shyrzaza/MicroMouseArbeit/readme.txt

How to use

Install 

Python 3.5
PyQT
PyQTGraph
PySerial

Send via UART

POS:XXXX:VEL:XXXX:SEN:XXXX:CON:XXXX 
(length of numbers is not important)
(look at uart.h sendDiagnostics() method
