shyrzaza/MicroMouseArbeit/PartList Mouse 2020.xlsx

 | Order number | Link | Price | Pack Size | Total | check
 | RS-Num |  | per part, without taxes
Motor: | - |  |  |  | 2
LEDs:
Throughhole | 862-2790 | https://de.rs-online.com/web/p/led/8622790/ | 0.069 | 100 | 2 | 2
 | 708-2787 | https://de.rs-online.com/web/p/led/7082787/ | 0.28 | 25 | 3 | 3
Capacitors:
100 nF | 264-4416 | https://de.rs-online.com/web/p/keramik-vielschichtkondensatoren/2644416/ | 0.162 | 25 | 8 | 8
330 nF | 698-3421 | https://de.rs-online.com/web/p/keramik-vielschichtkondensatoren/6983421/ | 0.334 | 25 | 1 | 1
470nF | 698-3437 | https://de.rs-online.com/web/p/keramik-vielschichtkondensatoren/6983437/ | 0.184 | 10 | 1 | 1
15 pF | 264-4242 | https://de.rs-online.com/web/p/keramik-vielschichtkondensatoren/2644242/ | 0.014 | 25 | 2 | 2
4,7 μF | 648-0581 | https://de.rs-online.com/web/p/tantal-elektrolytkondensator/6480581/ | 0.27 | 10 | 1 | 1
33 uF Tantalum | 135-5417 | https://de.rs-online.com/web/p/tantal-elektrolytkondensator/1355417 | 1.1 | 5 | 1 | 1
Resistors:
47 kΩ | 223-0641 | https://de.rs-online.com/web/p/smd-widerstande/2230641/ | 0.03 | 50 | 2 | 2
62 Ω | 828-0869 | https://de.rs-online.com/web/p/smd-widerstande/8280869/ | 0.112 | 45 | 2 | 2
680 Ω | 679-1614 | https://de.rs-online.com/web/p/smd-widerstande/6791614/ | 0.004 | 50 | 3 | 3
4.7 KΩ | 223-0528 | https://de.rs-online.com/web/p/smd-widerstande/2230528/ | 0.028 | 50 | 2 | 2 | transistor
Diodes:
 | 708-2197 | https://de.rs-online.com/web/p/gleichrichterdioden-und-schottky-dioden/7082197/ | 0.259 | 25 | 9 | 9
Pin Headers:
2x5 Straight Male | 745-7059 | https://de.rs-online.com/web/p/leiterplatten-header/7457059/ | 0.323 | 10 | 1
2x3 Straight Male | 745-7046 | https://de.rs-online.com/web/p/leiterplatten-header/7457046/ | 0.226 | 10 | 2
1x6 Straight Female | 674-1546 | https://de.rs-online.com/web/p/leiterplatten-buchsen/6741546/ | 1.61 | 5 | 1
DIL Socket | 674-2432 | https://de.rs-online.com/web/p/dil-sockel/6742432/ | 0.206 | 10 | 1
Transistors:
 | 509-273 | https://de.rs-online.com/web/p/mosfet/0509273/?searchHistory=%7B%22enabled%22%3Atrue%7D | 0.254 | 20 | 2 | 2
Voltage regulators:
5V | 536-1546 | https://de.rs-online.com/web/p/ldo-spannungsregler/5361546/?searchHistory=%7B%22enabled%22%3Atrue%7D | 1.47 | 1 | 1 | 1
3.3V LD falsch? | 197-7281 | https://de.rs-online.com/web/p/ldo-spannungsregler/1977281/ | 1.38 | 5 | 1 | 1
Other:
H-Bridge | 714-0613 | https://de.rs-online.com/web/p/motor-treiber-ics/7140613/ | 3.3 | 1 | 1 | 1
Sensor | 146-0786 | https://de.rs-online.com/web/p/reflexions-lichtschranke/1460786/ | 7.16 | 1 | 3 | 3
Button | 135-9548 | https://de.rs-online.com/web/p/tastschalter/1359548/ | 0.169 | 20 | 2 | 2
Oscillator 16MHz |  |  |  |  | 1 | 1
BT-Serial-Modul |  |  |  |  | 1 | 1
Microcontroller | 823-3425 | https://de.rs-online.com/web/p/digitale-signalprozessoren/8233425/ | 5.95 | 1 | 1 | 1
Battery Connector |  |  |  |  | 1 | 1
