shyrzaza/MicroMouseArbeit/3DDruck/SensorMountSides.stl

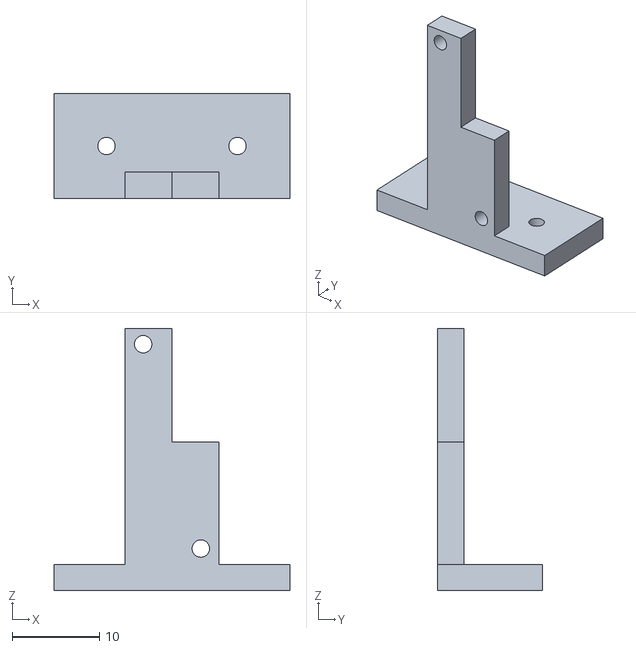
[picture p1: CAD file, 2020-09-17]
3DDruck/SensorMountSides.stl
27.0 x 12.0 x 30.0
