shyrzaza/MicroMouseArbeit/3DDruck/motormount.stl

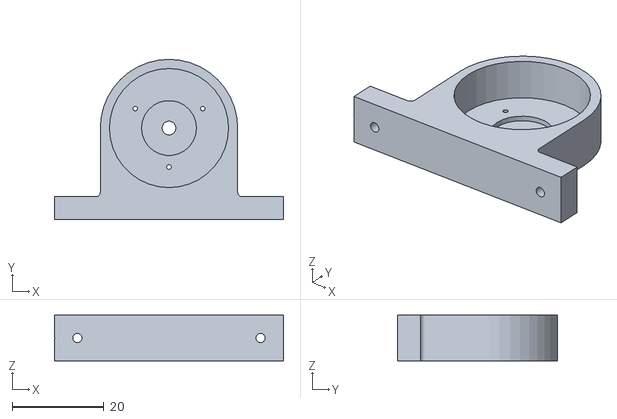
[picture p2: CAD file, 2020-09-17]
3DDruck/motormount.stl
50.0 x 35.0 x 10.0
