shyrzaza/MicroMouseArbeit/(list of files, cad)

Other CAD files:
3DDruck/SensorMountFront.stl
