shyrzaza/MicroMouseArbeit/Python/Debug.txt

POS:1:VEL:10:SENSOR:20:CON:5
POS:2:VEL:10:SENSOR:20:CON:5
POS:3:VEL:10:SENSOR:20:CON:5
POS:4:VEL:10:SENSOR:20:CON:5
POS:5:VEL:10:SENSOR:20:CON:5
POS:6:VEL:10:SENSOR:20:CON:5
POS:7:VEL:10:SENSOR:20:CON:5
POS:8:VEL:10:SENSOR:20:CON:5
POS:9:VEL:10:SENSOR:20:CON:5
POS:10:VEL:20:SENSOR:20:CON:5
POS:11:VEL:20:SENSOR:20:CON:5
POS:12:VEL:20:SENSOR:20:CON:5
POS:13:VEL:20:SENSOR:20:CON:5
POS:14:VEL:20:SENSOR:20:CON:5
POS:15:VEL:20:SENSOR:20:CON:5
POS:16:VEL:20:SENSOR:20:CON:5
POS:17:VEL:20:SENSOR:20:CON:5
POS:18:VEL:20:SENSOR:20:CON:5
POS:19:VEL:20:SENSOR:20:CON:5
POS:20:VEL:20:SENSOR:20:CON:5
POS:21:VEL:20:SENSOR:20:CON:5
POS:22:VEL:10:SENSOR:20:CON:5
POS:23:VEL:10:SENSOR:20:CON:5
POS:24:VEL:10:SENSOR:20:CON:5
POS:25:VEL:10:SENSOR:20:CON:5
POS:26:VEL:10:SENSOR:20:CON:5
POS:27:VEL:30:SENSOR:20:CON:5
POS:28:VEL:30:SENSOR:20:CON:5
POS:29:VEL:30:SENSOR:20:CON:5
POS:31:VEL:30:SENSOR:20:CON:5
POS:32:VEL:30:SENSOR:20:CON:5
POS:33:VEL:30:SENSOR:20:CON:5
POS:34:VEL:30:SENSOR:20:CON:5
POS:35:VEL:30:SENSOR:20:CON:5
POS:36:VEL:30:SENSOR:20:CON:5
POS:37:VEL:30:SENSOR:20:CON:5
POS:38:VEL:30:SENSOR:20:CON:5
POS:39:VEL:30:SENSOR:20:CON:5
POS:41:VEL:30:SENSOR:20:CON:5
POS:42:VEL:30:SENSOR:20:CON:5
POS:43:VEL:30:SENSOR:20:CON:5
POS:44:VEL:30:SENSOR:20:CON:5
POS:45:VEL:10:SENSOR:20:CON:5
POS:46:VEL:10:SENSOR:20:CON:5
POS:47:VEL:10:SENSOR:20:CON:5
POS:48:VEL:10:SENSOR:20:CON:5
POS:49:VEL:10:SENSOR:20:CON:5
POS:51:VEL:10:SENSOR:20:CON:5
POS:52:VEL:10:SENSOR:20:CON:5
POS:53:VEL:10:SENSOR:20:CON:5
POS:54:VEL:10:SENSOR:20:CON:5
POS:55:VEL:10:SENSOR:20:CON:5
POS:56:VEL:10:SENSOR:20:CON:5
POS:57:VEL:10:SENSOR:20:CON:5
POS:58:VEL:10:SENSOR:20:CON:5
POS:59:VEL:10:SENSOR:20:CON:5
POS:61:VEL:10:SENSOR:20:CON:5
POS:62:VEL:10:SENSOR:20:CON:5
POS:63:VEL:10:SENSOR:20:CON:5
POS:64:VEL:10:SENSOR:20:CON:5
POS:65:VEL:10:SENSOR:20:CON:5
POS:66:VEL:10:SENSOR:20:CON:5
POS:67:VEL:10:SENSOR:20:CON:5
POS:68:VEL:10:SENSOR:20:CON:5
POS:69:VEL:10:SENSOR:20:CON:5
POS:71:VEL:10:SENSOR:20:CON:5
POS:72:VEL:10:SENSOR:20:CON:5
POS:73:VEL:10:SENSOR:20:CON:5
POS:74:VEL:10:SENSOR:20:CON:5
POS:75:VEL:10:SENSOR:20:CON:5
POS:76:VEL:10:SENSOR:20:CON:5
POS:77:VEL:10:SENSOR:20:CON:5
POS:78:VEL:10:SENSOR:20:CON:5
POS:79:VEL:10:SENSOR:20:CON:5
POS:81:VEL:10:SENSOR:20:CON:5
POS:82:VEL:10:SENSOR:20:CON:5
POS:83:VEL:10:SENSOR:20:CON:5
POS:84:VEL:10:SENSOR:20:CON:5
POS:85:VEL:10:SENSOR:20:CON:5
POS:86:VEL:10:SENSOR:20:CON:5
POS:87:VEL:10:SENSOR:20:CON:5
POS:88:VEL:10:SENSOR:20:CON:5
POS:89:VEL:10:SENSOR:20:CON:5
POS:91:VEL:10:SENSOR:20:CON:5
POS:92:VEL:10:SENSOR:20:CON:5
POS:93:VEL:10:SENSOR:20:CON:5
POS:94:VEL:10:SENSOR:20:CON:5
POS:95:VEL:10:SENSOR:20:CON:5
POS:96:VEL:10:SENSOR:20:CON:5
POS:97:VEL:10:SENSOR:20:CON:5
POS:98:VEL:10:SENSOR:20:CON:5
POS:99:VEL:10:SENSOR:20:CON:5
