shyrzaza/MicroMouseArbeit/source eagle/projects/micromouse/micromouse.brd

## EAGLE design source eagle/projects/micromouse/micromouse.brd (2020-11-19)

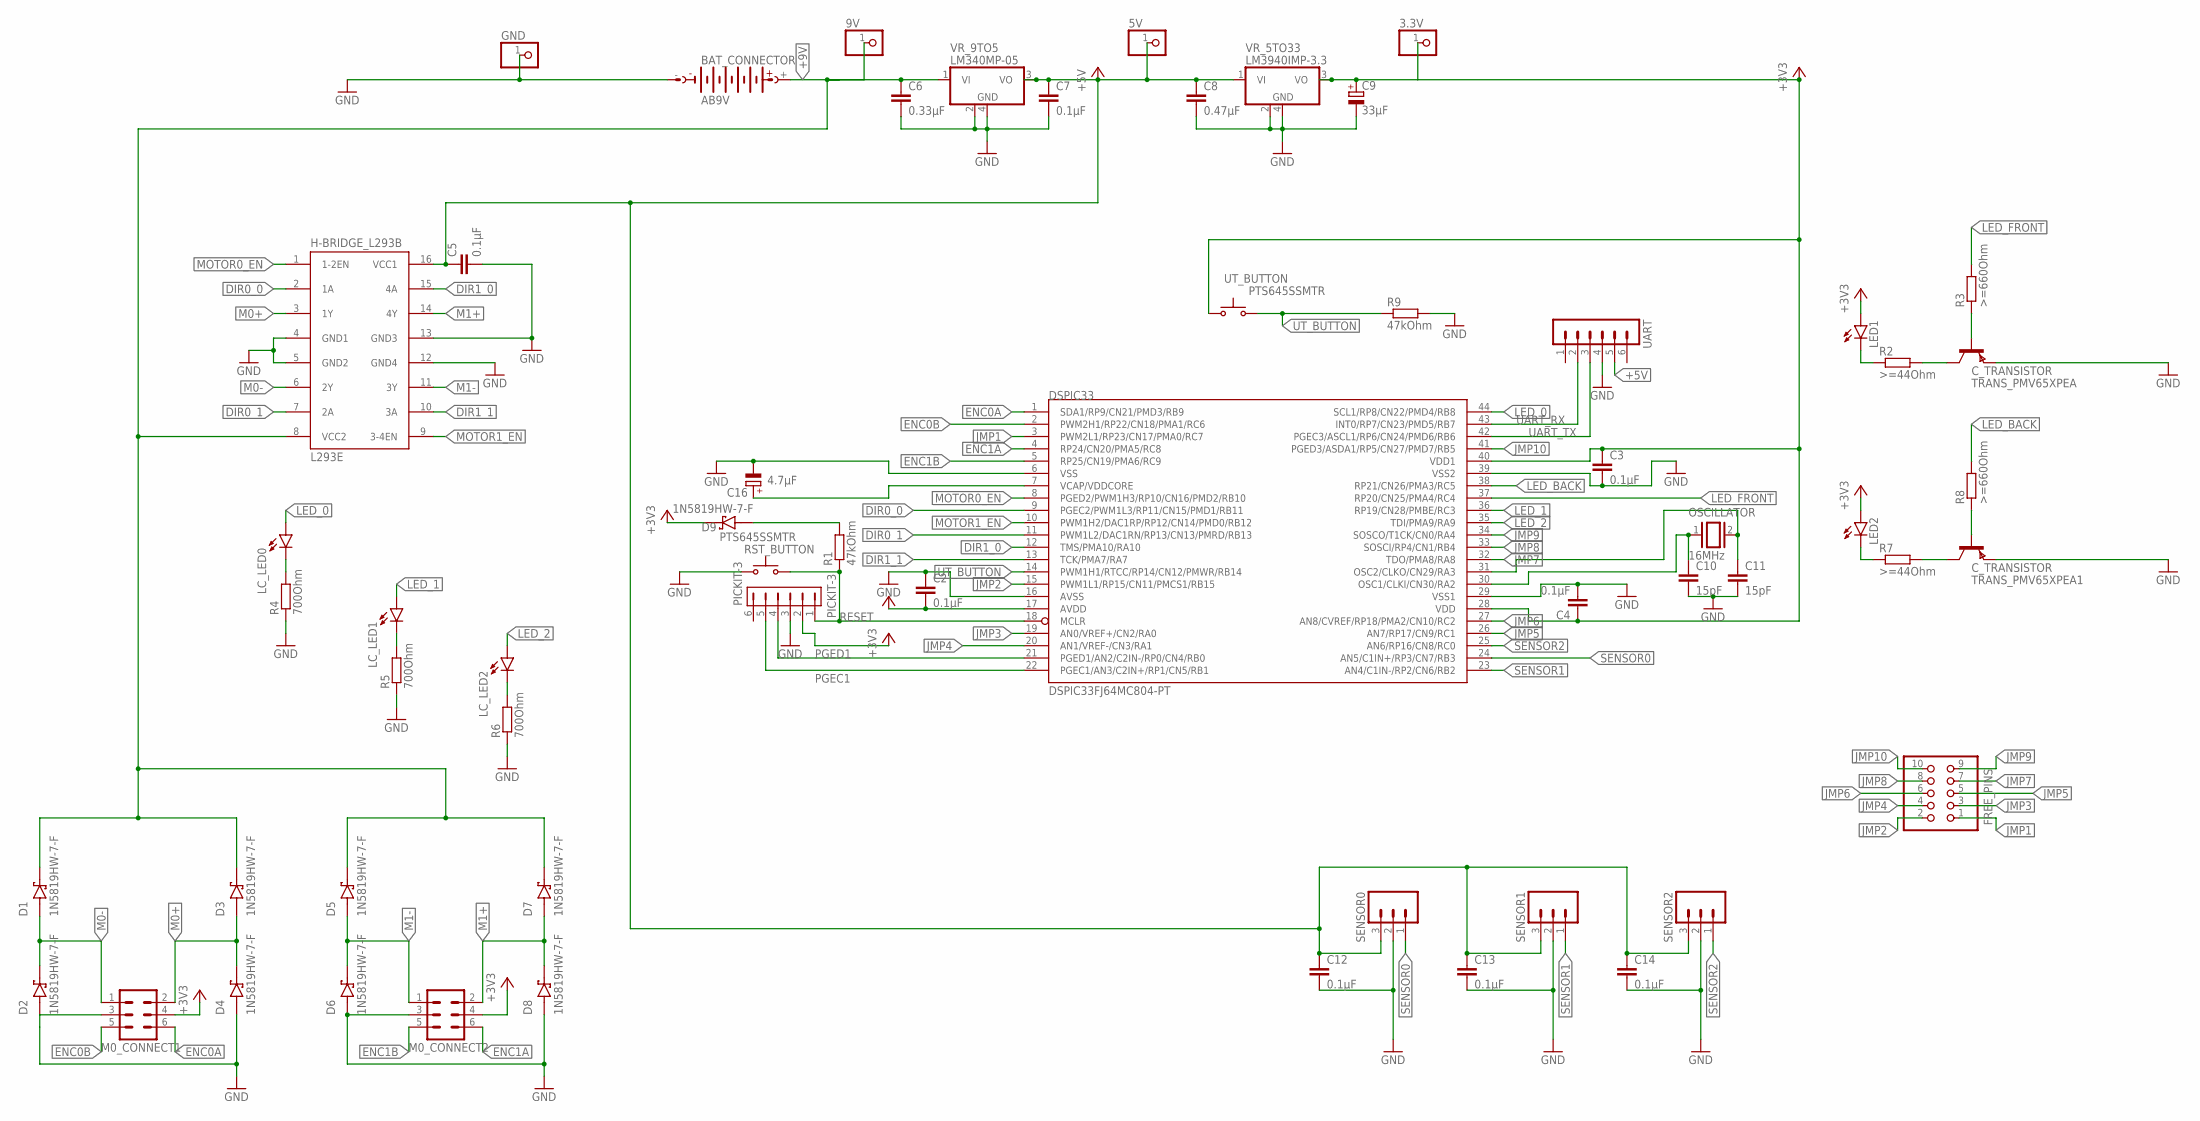
[picture p3: schematic micromouse.sch]

Parts:
3.3V, 5V, 9V: PINHD-1X1; 1X01
BAT_CONNECTOR: AB9V
C2, C3, C4, C5, C7, C12, C13, C14: 0.1µF; C0805
C6: 0.33µF; C0805
C8: 0.47µF; C0805
C9: 33µF; D/7343-31W
C10, C11: 15pF; C0805
C16: 4.7µF; CT3528
D1, D2, D3, D4, D5, D6, D7, D8, D9: 1N5819HW-7-F; SOD3715X145N
DSPIC33: DSPIC33FJ64MC804-PT; TQFP44
FREE_PINS: PINHD-2X5; 2X05
GND: PINHD-1X1; 1X01
H-BRIDGE_L293B: L293E; DIL16
LC_LED0, LC_LED1, LC_LED2: LED5MM
LED1, LED2: L-1503ID-LED-DLED; L-1503ID-LED
M0_CONNECT1, M0_CONNECT2: MA03-2
OSCILLATOR: 16MHz; QS
PICKIT-3: PICKIT-3; 1X06
R1, R9: 47kOhm; R0805
R2, R7: >=44Ohm; R0805
R3, R8: >=660Ohm; R0805
R4, R5, R6: 700Ohm; R0805
RST_BUTTON: PTS645SSMTR; PTS645-SMD
SENSOR0, SENSOR1, SENSOR2: M03; 03P
TRANS_PMV65XPEA, TRANS_PMV65XPEA1: C_TRANSISTOR; SOT23
UART: MA06-1
UT_BUTTON: PTS645SSMTR; PTS645-SMD
VR_5TO33: LM3940IMP-3.3; SOT223
VR_9TO5: LM340MP-05; SOT223

Connections:
+3V3: 3.3V.1, C2.2, C3.1, C4.1, C9.+, D9.C (K), DSPIC33.17 (AVDD), DSPIC33.28 (VDD), DSPIC33.40 (VDD1), LED1.A, LED2.A, M0_CONNECT1.4, M0_CONNECT2.4, PICKIT-3.2 (VDD), UT_BUTTON.1, UT_BUTTON.2, VR_5TO33.3 (VO)
+5V: 5V.1, C5.1, C7.1, C8.1, C12.1, C13.1, C14.1, H-BRIDGE_L293B.16 (VCC1), SENSOR0.3, SENSOR1.3, SENSOR2.3, UART.5, VR_5TO33.1 (VI), VR_9TO5.3 (VO)
+9V: 9V.1, BAT_CONNECTOR.+, C6.1, D1.C (K), D3.C (K), D5.C (K), D7.C (K), H-BRIDGE_L293B.8 (VCC2), VR_9TO5.1 (VI)
DIR0_0: DSPIC33.9 (PGEC2/PWM1L3/RP11/CN15/PMD1/RB11), H-BRIDGE_L293B.2 (1A)
DIR0_1: DSPIC33.11 (PWM1L2/DAC1RN/RP13/CN13/PMRD/RB13), H-BRIDGE_L293B.7 (2A)
DIR1_0: DSPIC33.12 (TMS/PMA10/RA10), H-BRIDGE_L293B.15 (4A)
DIR1_1: DSPIC33.13 (TCK/PMA7/RA7), H-BRIDGE_L293B.10 (3A)
ENC0A: DSPIC33.1 (SDA1/RP9/CN21/PMD3/RB9), M0_CONNECT1.6
ENC0B: DSPIC33.2 (PWM2H1/RP22/CN18/PMA1/RC6), M0_CONNECT1.5
ENC1A: DSPIC33.4 (RP24/CN20/PMA5/RC8), M0_CONNECT2.6
ENC1B: DSPIC33.5 (RP25/CN19/PMA6/RC9), M0_CONNECT2.5
GND: BAT_CONNECTOR.-, C2.1, C3.2, C4.2, C5.2, C6.2, C7.2, C8.2, C9.-, C10.2, C11.2, C12.2, C13.2, C14.2, C16.-, D2.A, D4.A, D6.A, D8.A, DSPIC33.6 (VSS), DSPIC33.16 (AVSS), DSPIC33.29 (VSS1), DSPIC33.39 (VSS2), GND.1, H-BRIDGE_L293B.4 (GND1), H-BRIDGE_L293B.5 (GND2), H-BRIDGE_L293B.12 (GND4), H-BRIDGE_L293B.13 (GND3), M0_CONNECT1.3, M0_CONNECT2.3, PICKIT-3.3 (VSS), R4.1, R5.1, R6.1, R9.2, RST_BUTTON.1, RST_BUTTON.2, SENSOR0.2, SENSOR1.2, SENSOR2.2, TRANS_PMV65XPEA.2 (E), TRANS_PMV65XPEA1.2 (E), UART.4, VR_5TO33.2 (GND1), VR_5TO33.4 (GND), VR_9TO5.2 (GND1), VR_9TO5.4 (GND)
JMP1: DSPIC33.3 (PWM2L1/RP23/CN17/PMA0/RC7), FREE_PINS.1
JMP2: DSPIC33.15 (PWM1L1/RP15/CN11/PMCS1/RB15), FREE_PINS.2
JMP3: DSPIC33.19 (AN0/VREF+/CN2/RA0), FREE_PINS.3
JMP4: DSPIC33.20 (AN1/VREF-/CN3/RA1), FREE_PINS.4
JMP5: DSPIC33.26 (AN7/RP17/CN9/RC1), FREE_PINS.5
JMP6: DSPIC33.27 (AN8/CVREF/RP18/PMA2/CN10/RC2), FREE_PINS.6
JMP7: DSPIC33.32 (TDO/PMA8/RA8), FREE_PINS.7
JMP8: DSPIC33.33 (SOSCI/RP4/CN1/RB4), FREE_PINS.8
JMP9: DSPIC33.34 (SOSCO/T1CK/CN0/RA4), FREE_PINS.9
JMP10: DSPIC33.41 (PGED3/ASDA1/RP5/CN27/PMD7/RB5), FREE_PINS.10
LED_0: DSPIC33.44 (SCL1/RP8/CN22/PMD4/RB8), LC_LED0.A
LED_1: DSPIC33.36 (RP19/CN28/PMBE/RC3), LC_LED1.A
LED_2: DSPIC33.35 (TDI/PMA9/RA9), LC_LED2.A
LED_BACK: DSPIC33.38 (RP21/CN26/PMA3/RC5), R8.2
LED_FRONT: DSPIC33.37 (RP20/CN25/PMA4/RC4), R3.2
M0+: D3.A, D4.C (K), H-BRIDGE_L293B.3 (1Y), M0_CONNECT1.2
M0-: D1.A, D2.C (K), H-BRIDGE_L293B.6 (2Y), M0_CONNECT1.1
M1+: D7.A, D8.C (K), H-BRIDGE_L293B.14 (4Y), M0_CONNECT2.2
M1-: D5.A, D6.C (K), H-BRIDGE_L293B.11 (3Y), M0_CONNECT2.1
MOTOR0_EN: DSPIC33.8 (PGED2/PWM1H3/RP10/CN16/PMD2/RB10), H-BRIDGE_L293B.1 (1-2EN)
MOTOR1_EN: DSPIC33.10 (PWM1H2/DAC1RP/RP12/CN14/PMD0/RB12), H-BRIDGE_L293B.9 (3-4EN)
unnamed: LED1.K (C), R2.1
unnamed: D9.A, R1.2
unnamed: LC_LED1.K (C), R5.2
unnamed: LC_LED2.K (C), R6.2
unnamed: LC_LED0.K (C), R4.2
unnamed: R2.2, TRANS_PMV65XPEA.3 (C)
unnamed: R3.1, TRANS_PMV65XPEA.1 (B)
unnamed: LED2.K (C), R7.1
unnamed: R7.2, TRANS_PMV65XPEA1.3 (C)
unnamed: R8.1, TRANS_PMV65XPEA1.1 (B)
OSC1: C10.1, DSPIC33.30 (OSC1/CLKI/CN30/RA2), OSCILLATOR.1
OSC2: C11.1, DSPIC33.31 (OSC2/CLKO/CN29/RA3), OSCILLATOR.2
PGEC1: DSPIC33.22 (PGEC1/AN3/C2IN+/RP1/CN5/RB1), PICKIT-3.5 (PGC)
PGED1: DSPIC33.21 (PGED1/AN2/C2IN-/RP0/CN4/RB0), PICKIT-3.4 (PGD)
RESET: DSPIC33.18 (MCLR), PICKIT-3.1 (MCLR), R1.1, RST_BUTTON.3 (S), RST_BUTTON.4 (S)
SENSOR0: DSPIC33.24 (AN5/C1IN+/RP3/CN7/RB3), SENSOR0.1
SENSOR1: DSPIC33.23 (AN4/C1IN-/RP2/CN6/RB2), SENSOR1.1
SENSOR2: DSPIC33.25 (AN6/RP16/CN8/RC0), SENSOR2.1
UART_RX: DSPIC33.43 (INT0/RP7/CN23/PMD5/RB7), UART.2
UART_TX: DSPIC33.42 (PGEC3/ASCL1/RP6/CN24/PMD6/RB6), UART.3
UT_BUTTON: DSPIC33.14 (PWM1H1/RTCC/RP14/CN12/PMWR/RB14), R9.1, UT_BUTTON.3 (S), UT_BUTTON.4 (S)
VCAP/VDDCORE: C16.+, DSPIC33.7 (VCAP/VDDCORE)

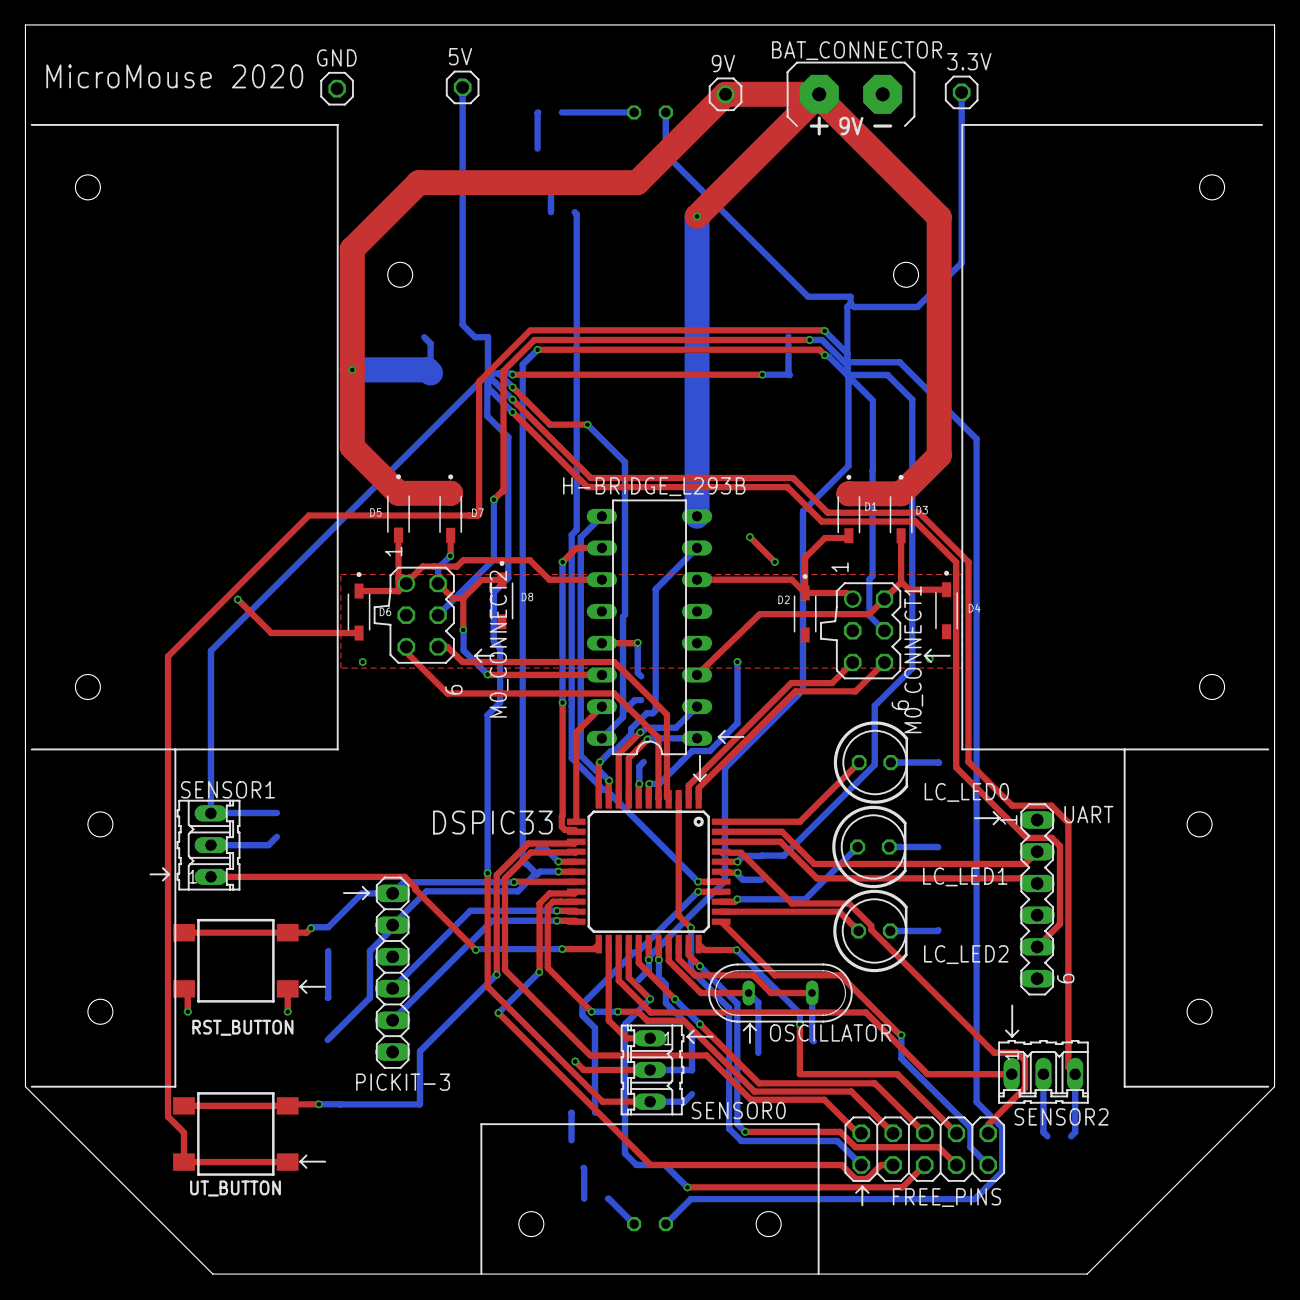
[picture p4: board micromouse.brd from above]

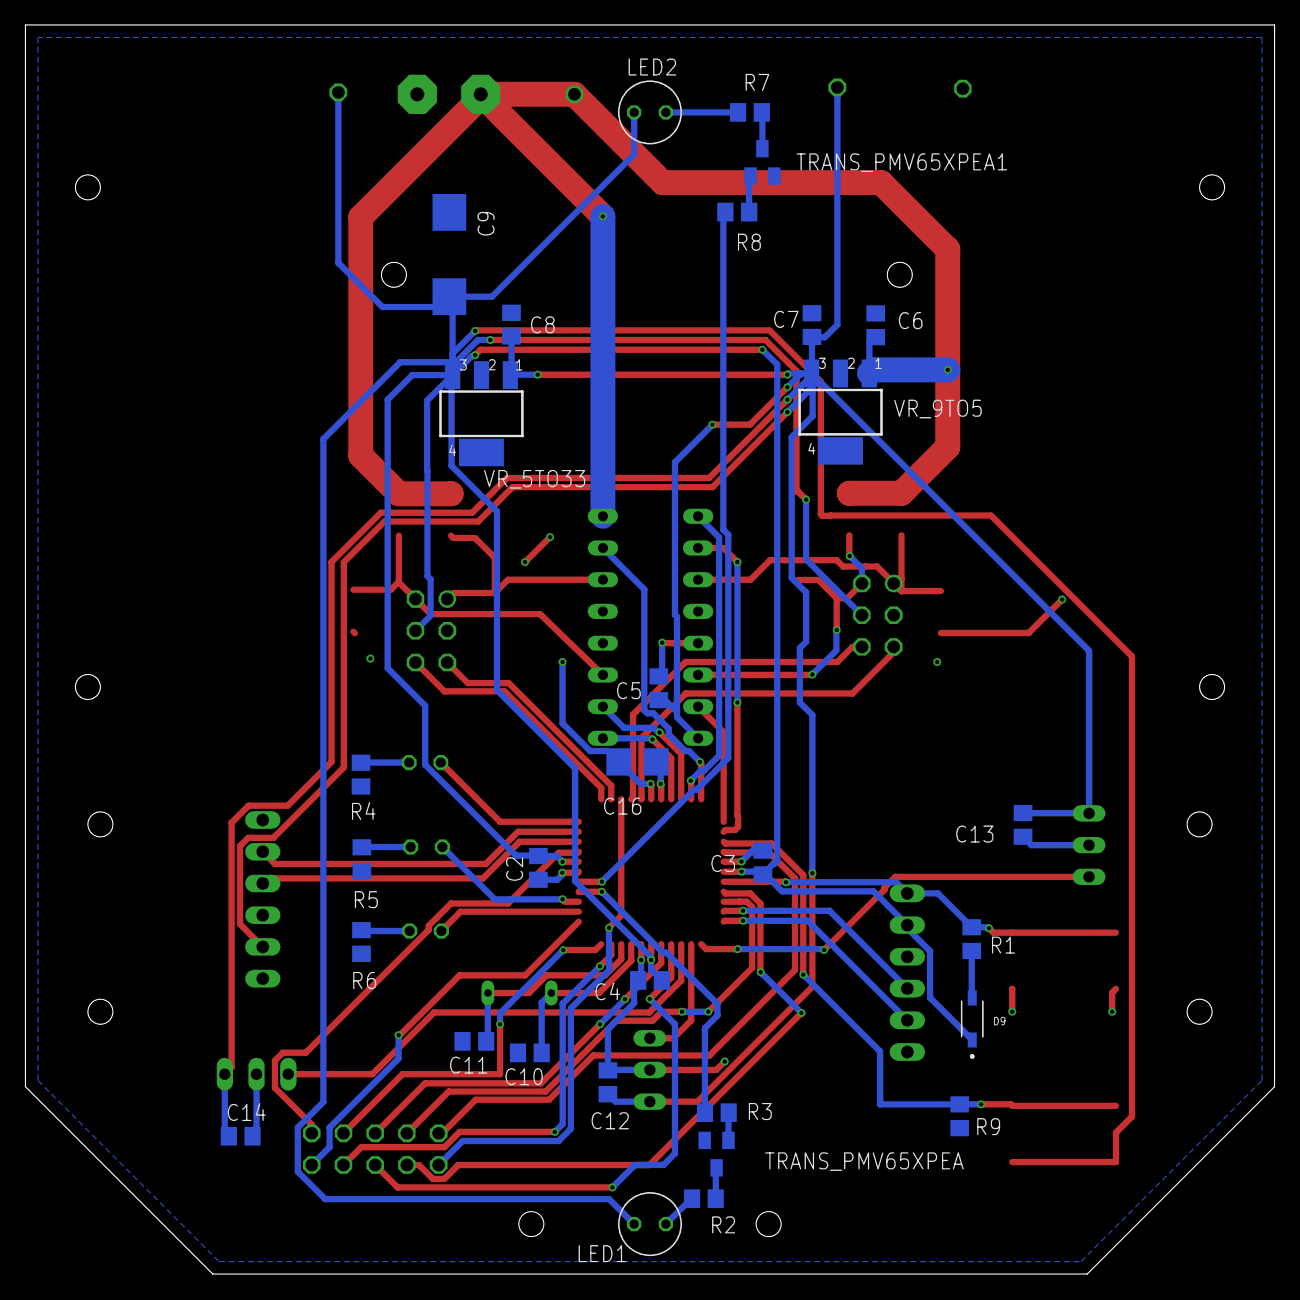
[picture p5: board micromouse.brd from below]

Board: 2 copper layers, 100.0 x 100.0 mm, 59 parts (30 on the bottom side), 55 nets.
