shyrzaza/MicroMouseArbeit/(commit log)

2020-07-28 laptop init
    [micromouse.brd, micromouse.sch]
2020-07-28 better board design, capacitor missing
    [micromouse.brd]
2020-08-12 Matlab logging
    [forMatlabh.csv, okay.csv]
2020-08-12 Board fertig, vllt noch silk?
    [micromouse.brd, micromouse.sch]
2020-09-17 motor and sensor mount files added
    [SensorMountFront.stl, SensorMountSides.stl, motormount.stl]
2020-09-17 small changes to board and matlab files
    [micromouse.brd, output.csv]
2020-11-19 updated ld voltage regulator 3.3v
    [PartList Mouse 2020.xlsx]
