shyrzaza/MicroMouseArbeit/(notices)

Notices in the files:
parts and their libraries:
switch-ck: Copyright (C) 2011, Bob Starr
